ia31/mini-piano-pcb/PCB Design.pdf

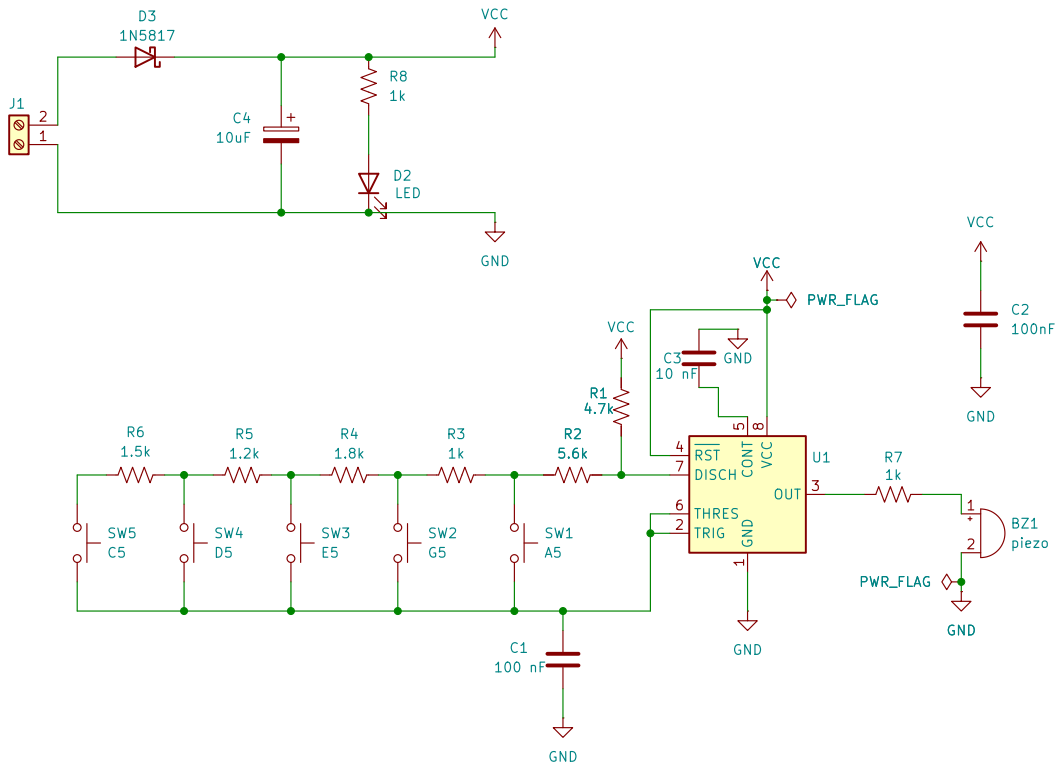
[picture p2: page 1]

Size: A4 | Rev: vOCT 26
KiCad E.D.A. 10.0.6 | Id: 1/1
