ia31/mini-piano-pcb/PCB Design-B_Cu.pdf

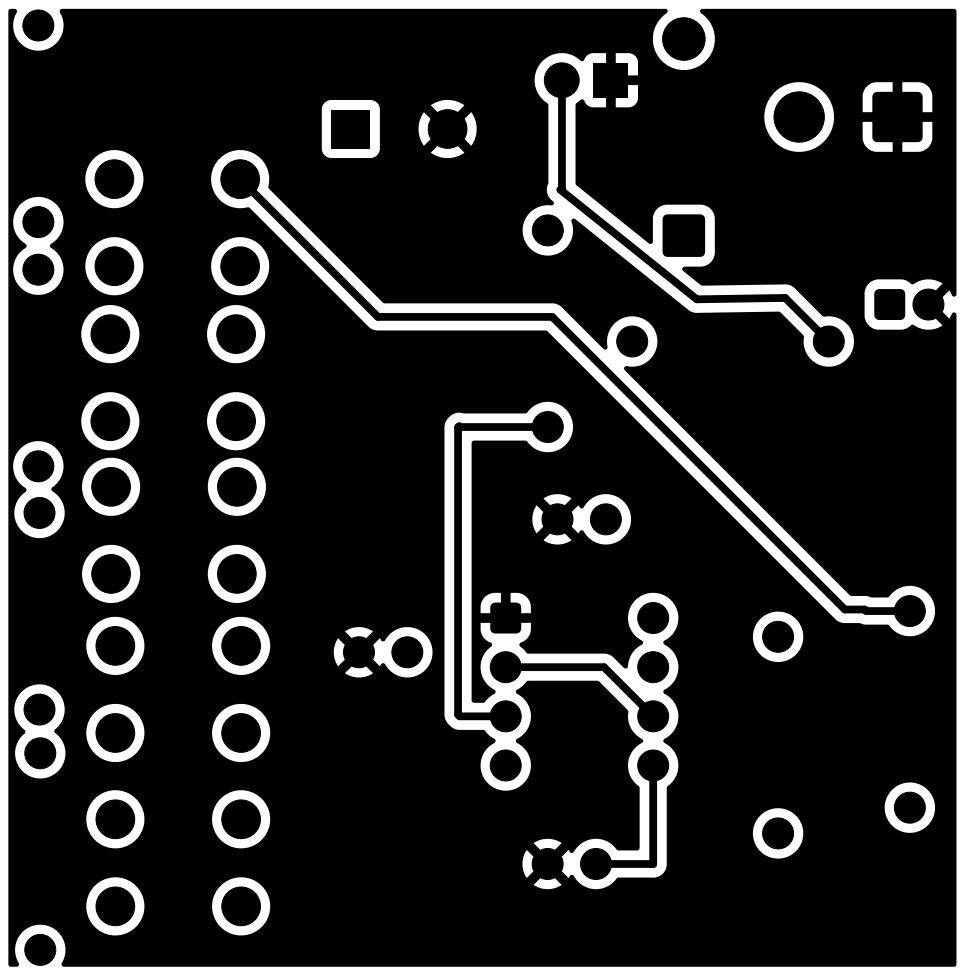
[picture p3: page 1]
