ia31/mini-piano-pcb/PCB Design-F_Cu.pdf

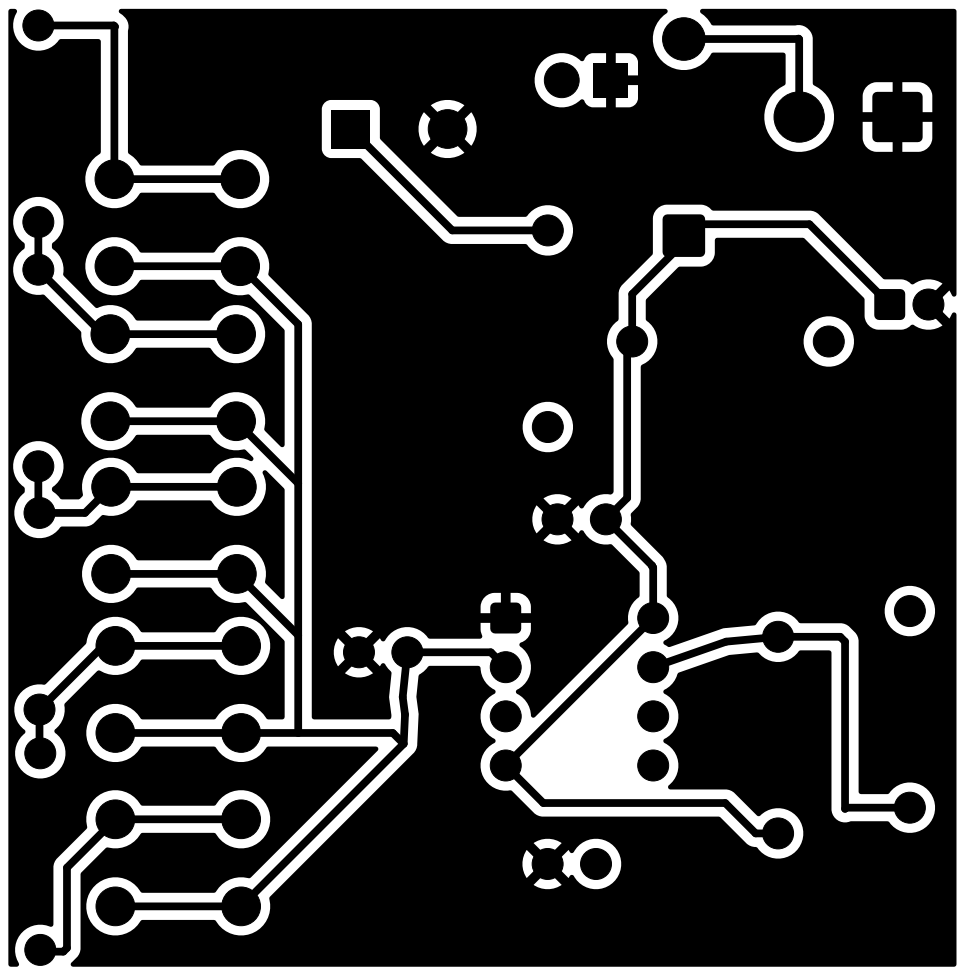
[picture p4: page 1]
