ia31/mini-piano-pcb/PCB Design.kicad_pcb

## KiCad design PCB Design.kicad_pcb (2026-10-26)

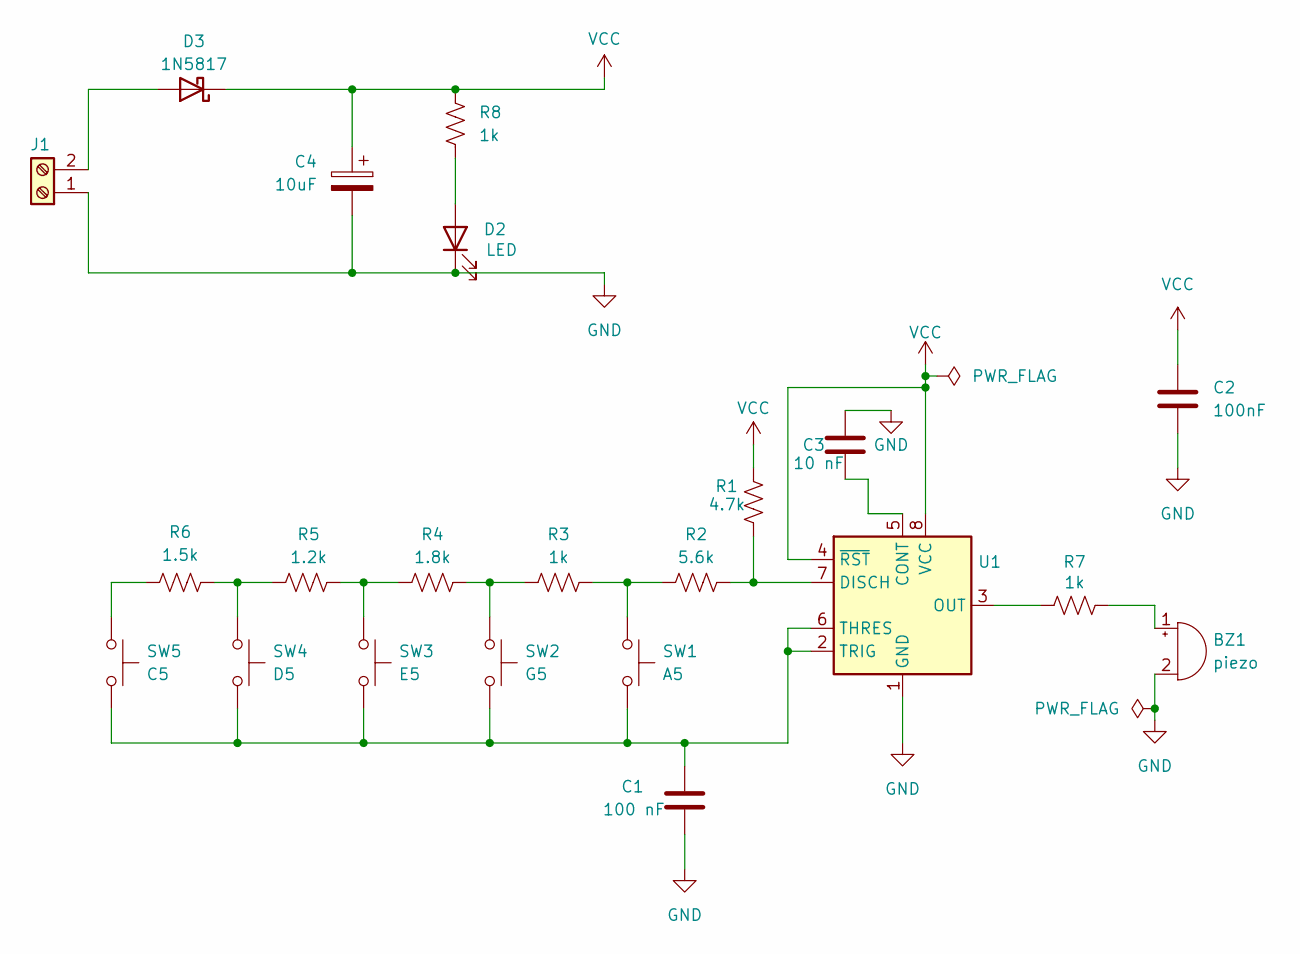
[picture p5: schematic PCB Design.kicad_sch, Mini Piano]

Parts:
BZ1: piezo; Buzzer_TDK_PS1240P02BT_D12.2mm_H6.5mm
C1: 100 nF; C_Disc_D5.0mm_W2.5mm_P2.50mm
C2: 100nF; C_Disc_D5.0mm_W2.5mm_P2.50mm
C3: 10 nF; C_Disc_D5.0mm_W2.5mm_P2.50mm
C4: 10uF; CP_Radial_D5.0mm_P2.00mm
D2: LED; LED_D5.0mm
D3: 1N5817; D_DO-41_SOD81_P10.16mm_Horizontal
J1: Screw_Terminal_01x02; TerminalBlock_Phoenix_MKDS-1,5-2-5.08_1x02_P5.08mm_Horizont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
R1: 4.7k; R_Axial_DIN0207_L6.3mm_D2.5mm_P10.16mm_Horizontal
R2: 5.6k; R_Axial_DIN0207_L6.3mm_D2.5mm_P10.16mm_Horizontal
R3, R7, R8: 1k; R_Axial_DIN0207_L6.3mm_D2.5mm_P10.16mm_Horizontal
R4: 1.8k; R_Axial_DIN0207_L6.3mm_D2.5mm_P10.16mm_Horizontal
R5: 1.2k; R_Axial_DIN0207_L6.3mm_D2.5mm_P10.16mm_Horizontal
R6: 1.5k; R_Axial_DIN0207_L6.3mm_D2.5mm_P10.16mm_Horizontal
SW1: A5; SW_PUSH_6mm
SW2: G5; SW_PUSH_6mm
SW3: E5; SW_PUSH_6mm
SW4: D5; SW_PUSH_6mm
SW5: C5; SW_PUSH_6mm
U1: LMC555xN; DIP-8_W7.62mm

Connections:
GND: BZ1.2 (-), C1.2, C2.2, C3.1, C4.2, D2.1 (K), J1.1, U1.1 (GND)
unnamed: BZ1.1 (+), R7.2
unnamed: D2.2 (A), R8.2
unnamed: D3.2 (A), J1.2
unnamed: R2.1, R3.2, SW1.1
unnamed: R3.1, R4.2, SW2.1
unnamed: R4.1, R5.2, SW3.1
unnamed: R5.1, R6.2, SW4.1
unnamed: R6.1, SW5.1
unnamed: C3.2, U1.5 (CONT)
unnamed: R1.2, R2.2, U1.7 (DISCH)
unnamed: R7.1, U1.3 (OUT)
unnamed: C1.1, SW1.2, SW2.2, SW3.2, SW4.2, SW5.2, U1.2 (TRIG), U1.6 (THRES)
VCC: C2.1, C4.1, D3.1 (K), R1.1, R8.1, U1.4 (~RST), U1.8 (VCC)

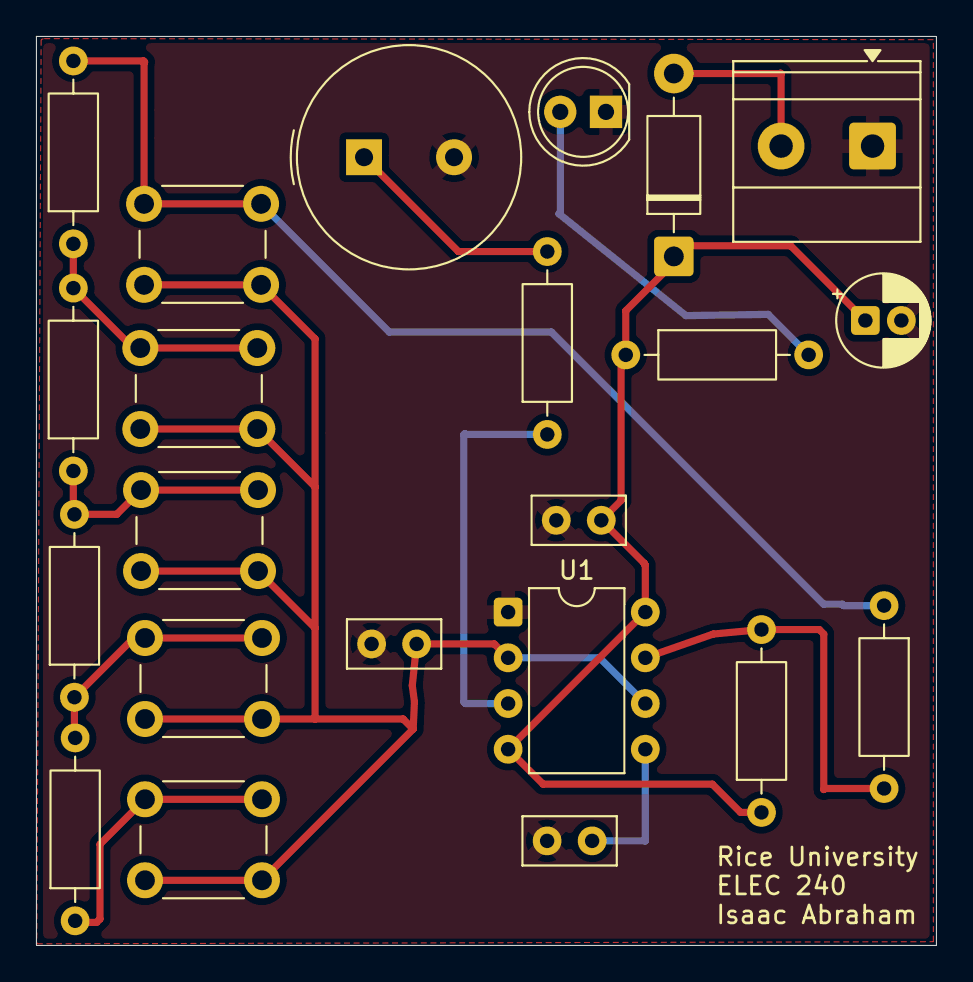
[picture p6: board PCB Design.kicad_pcb from above]

Board: 2 copper layers, 50.0 x 50.5 mm, 22 parts (0 on the bottom side), 14 nets.
